R411gun/Powercore-V2.0/Powercore-V2.0 Motherboard/KiCAD/CHARGER_POWER_STAGE.kicad_sch

## KiCad design Powercore-V2.0 Motherboard/KiCAD/CHARGER_POWER_STAGE.kicad_sch (2024-09-20)

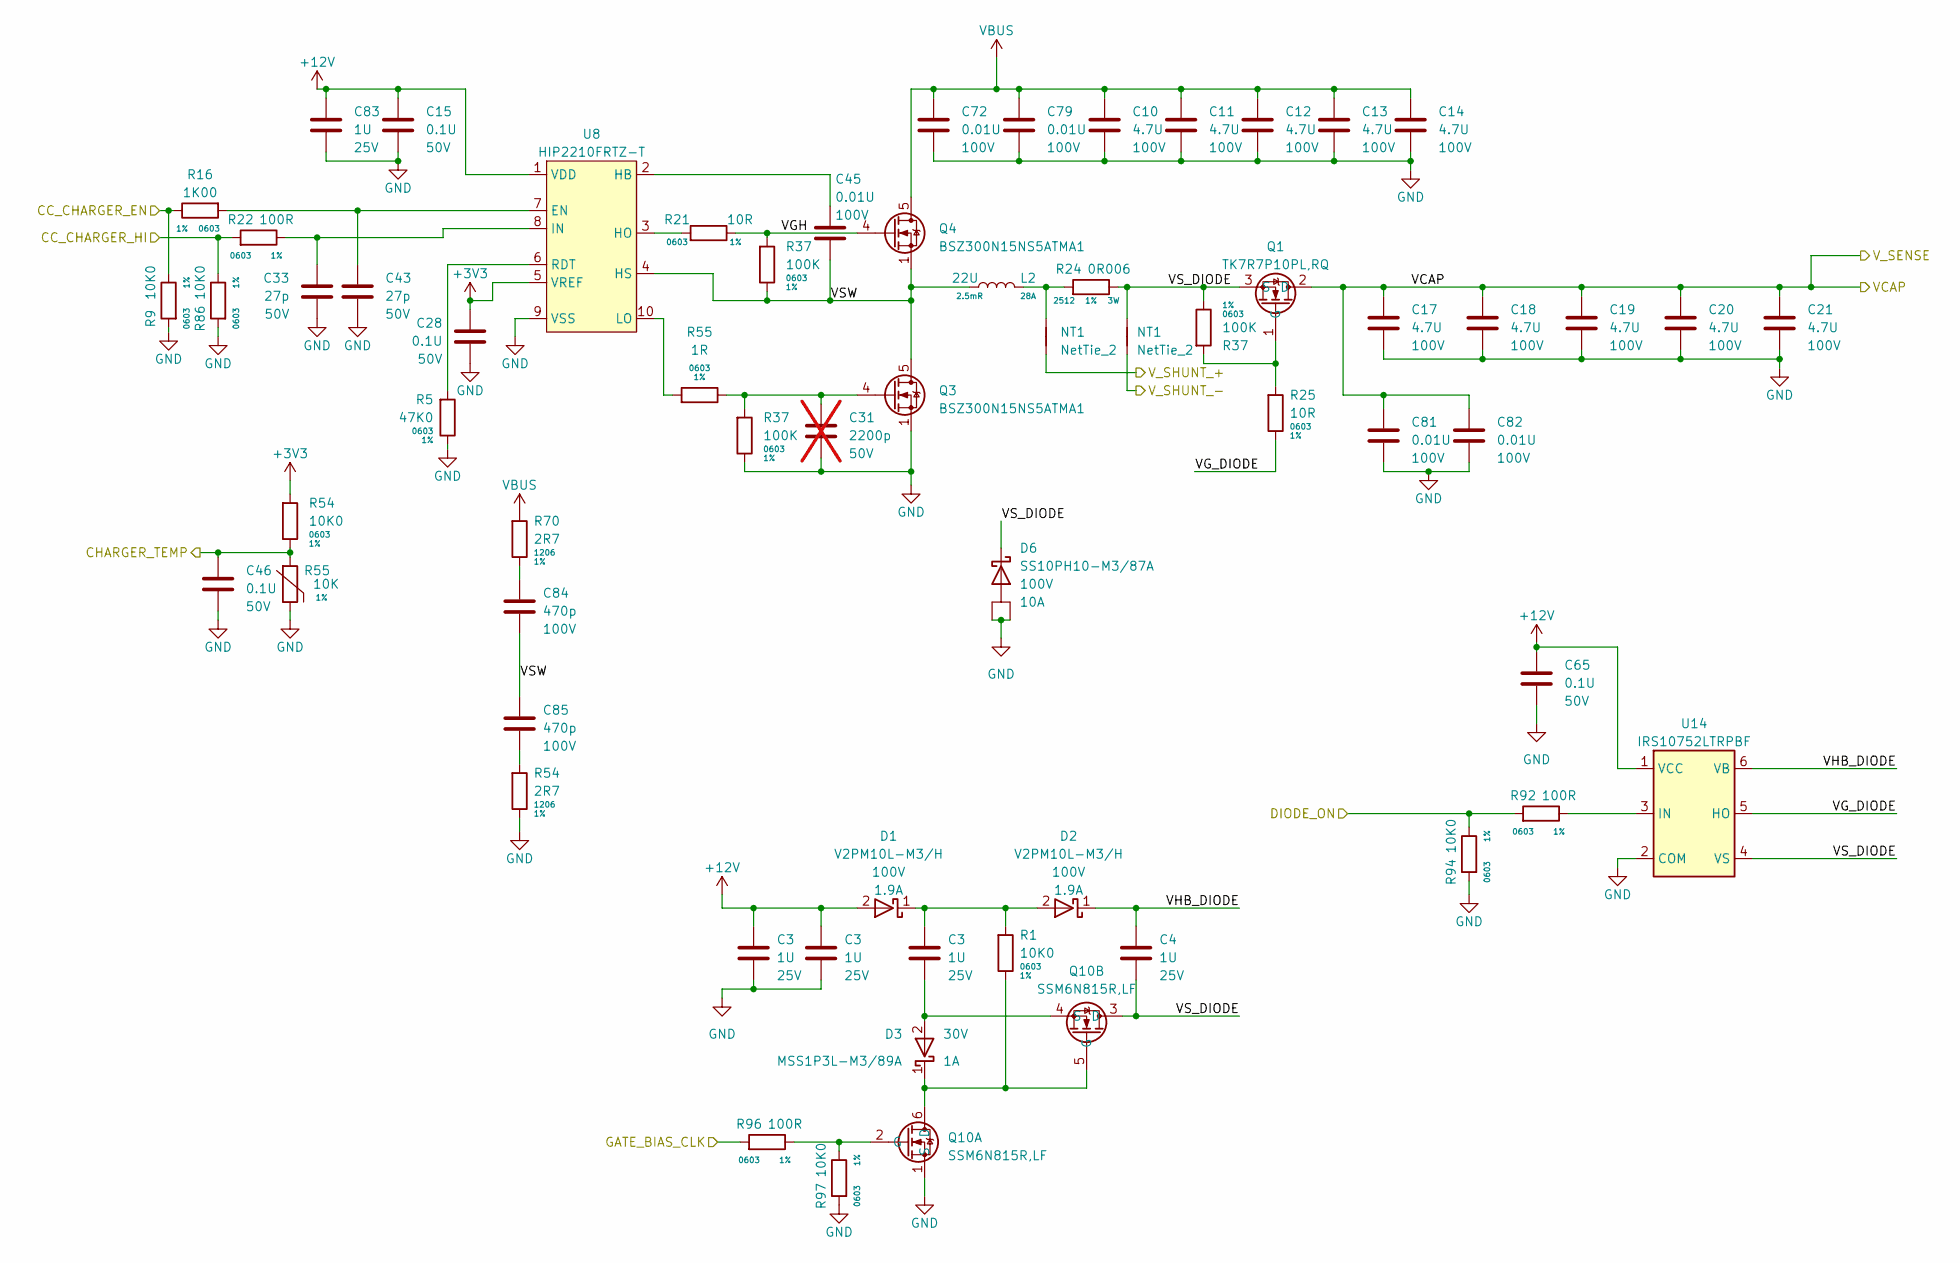
[picture p1: schematic CHARGER_POWER_STAGE.kicad_sch]

Parts:
C3, C4, C83: 1U; C_0603_1608Metric; Volage Rating 25V; Part Number CL10B105KA8NNNC
C10, C11, C12, C13, C14, C17, C18, C19, C20, C21: 4.7U; C_1206_3216Metric; Voltage Rating 100V; Part Number GRM31CC72A475KE11L
C15, C28, C46, C65: 0.1U; C_0603_1608Metric; Volage Rating 50V; Part Number CL10B104KB8NNWC
C31: 2200p; C_0603_1608Metric; Volage Rating 50V; Part Number CL10B222KB8NNNC; not fitted
C33, C43: 27p; C_0603_1608Metric; Volage Rating 50V; Part Number CC0603JRNPO9BN270
C45, C72, C79, C81, C82: 0.01U; C_0603_1608Metric; Volage Rating 100V; Part Number CL10B103KC8NNNC
C84, C85: 470p; C_0603_1608Metric; Volage Rating 100V; Part Number C0603C471J1GAC7867
D1, D2: V2PM10L-M3/H; DO-220AA (SMP); Voltage 100V; Part Number V2PM10L-M3/H
D3: MSS1P3L-M3/89A; D_MicroSMP_AK; Voltage 30V; Part Number MSS1P3L-M3/89A
D6: SS10PH10-M3/87A; TO-277A; Part Number SS10PH10-M3/87A
L2: 22U; PQ2617BHA; Part Number PQ2617BHA-220K
NT1: NetTie_2; NET_TIE_SMD_10mil
Q1: TK7R7P10PL,RQ; TO-252-2; Part Number TK7R7P10PL,RQ
Q3, Q4: BSZ300N15NS5ATMA1; INFINEON_TSDSON-8-25; Part Number BSZ300N15NS5ATMA1
Q10: SSM6N815R,LF; TSOP_6_2.5MM WIDTH; Part Number SSM6N815R,LF
R1, R9, R86, R94, R97: 10K0; R_0603_1608Metric; Tolerance 1%; Part Number RMCF0603FT10K0
R5: 47K0; R_0603_1608Metric; Tolerance 1%; Part Number RMCF0603FT47K0
R16: 1K00; R_0603_1608Metric; Tolerance 1%; Part Number RMCF0603FT1K00
R21, R25: 10R; R_0603_1608Metric; Tolerance 1%; Part Number RMCF0603FT10R0
R22, R92, R96: 100R; R_0603_1608Metric; Tolerance 1%; Part Number RMCF0603FT100R
R24: 0R006; CRE_2512_High_ohm; Tolerance 1%; Power Rating 3W; Part Number CRE2512-FZ-R006E-3
R37: 100K; R_0603_1608Metric; Tolerance 1%; Part Number RMCF0603FT100K
R54, R70: 2R7; R_1206_3216Metric; Tolerance 1%; Part Number CRCW12062R70JNEAHP
R55: 10K; R_0603_1608Metric; Tolerance 1%; Part Number NCU18XH103F60RB
U8: HIP2210FRTZ-T; TDFN-10_EP_2.6x3.0mm_P0.8mm; Part Number HIP2210FRTZ-T
U14: IRS10752LTRPBF; SOT-23-6; Part Number IRS10752LTRPBF

Connections:
+3V3: C28.1, R54.1, U8.5 (VREF)
+12V: C3.1, C15.1, C65.1, C83.1, D1.2 (A), U8.1 (VDD), U14.1 (VCC)
CC_CHARGER_EN: R9.2, R16.2
CC_CHARGER_HI: R22.1, R86.2
CHARGER_TEMP: C46.1, R54.2, R55.1
DIODE_ON: R92.1, R94.2
GATE_BIAS_CLK: R96.1
GND: C3.2, C10.2, C11.2, C12.2, C13.2, C14.2, C15.2, C17.2, C18.2, C19.2, C20.2, C21.2, C28.2, C31.2, C33.2, C43.2, C46.2, C65.2, C72.2, C79.2, C81.2, C82.2, C83.2, D6.1 (A), D6.2 (A), Q3.1 (S), Q10.1 (S), R5.2, R9.1, R37.2, R54.2, R55.2, R86.1, R94.1, R97.1, U8.9 (VSS), U8.EP (VSS), U14.2 (COM)
unnamed: C3.1, D1.1 (K), D2.2 (A), R1.1
unnamed: C3.2, D3.2 (A), Q10.4 (S)
unnamed: C31.1, Q3.4 (G), R37.1, R55.2
unnamed: C33.1, R22.2, U8.8 (IN)
unnamed: C43.1, R16.1, U8.7 (EN)
unnamed: C45.1, U8.2 (HB)
unnamed: C84.1, R70.2
unnamed: C85.2, R54.1
unnamed: D3.1 (K), Q10.5 (G), Q10.6 (D), R1.2
unnamed: L2.1, NT1.1, R24.1
unnamed: Q1.1 (G), R25.1, R37.1
unnamed: Q10.2 (G), R96.2, R97.2
unnamed: R5.1, U8.6 (RDT)
unnamed: R21.1, U8.3 (HO)
unnamed: R55.1, U8.10 (LO)
unnamed: R92.2, U14.3 (IN)
VBUS: C10.1, C11.1, C12.1, C13.1, C14.1, C72.1, C79.1, Q4.5 (D), R70.1
VGH: Q4.4 (G), R21.2, R37.1
VG_DIODE: R25.2, U14.5 (HO)
VHB_DIODE: C4.1, D2.1 (K), U14.6 (VB)
VSW: C45.2, C84.2, C85.1, L2.2, Q3.5 (D), Q4.1 (S), R37.2, U8.4 (HS)
VS_DIODE: C4.2, D6.3 (K), NT1.2, Q1.3 (S), Q10.3 (D), R24.2, R37.2, U14.4 (VS)
V_SENSE: C17.1, C18.1, C19.1, C20.1, C21.1, C81.1, C82.1, Q1.2 (D)
V_SHUNT_+: NT1.2
V_SHUNT_-: NT1.1
