R411gun/Powercore-V2.0/Powercore-V2.0 Motherboard/KiCAD/MICRO.kicad_sch

## KiCad design Powercore-V2.0 Motherboard/KiCAD/MICRO.kicad_sch (2024-09-20)

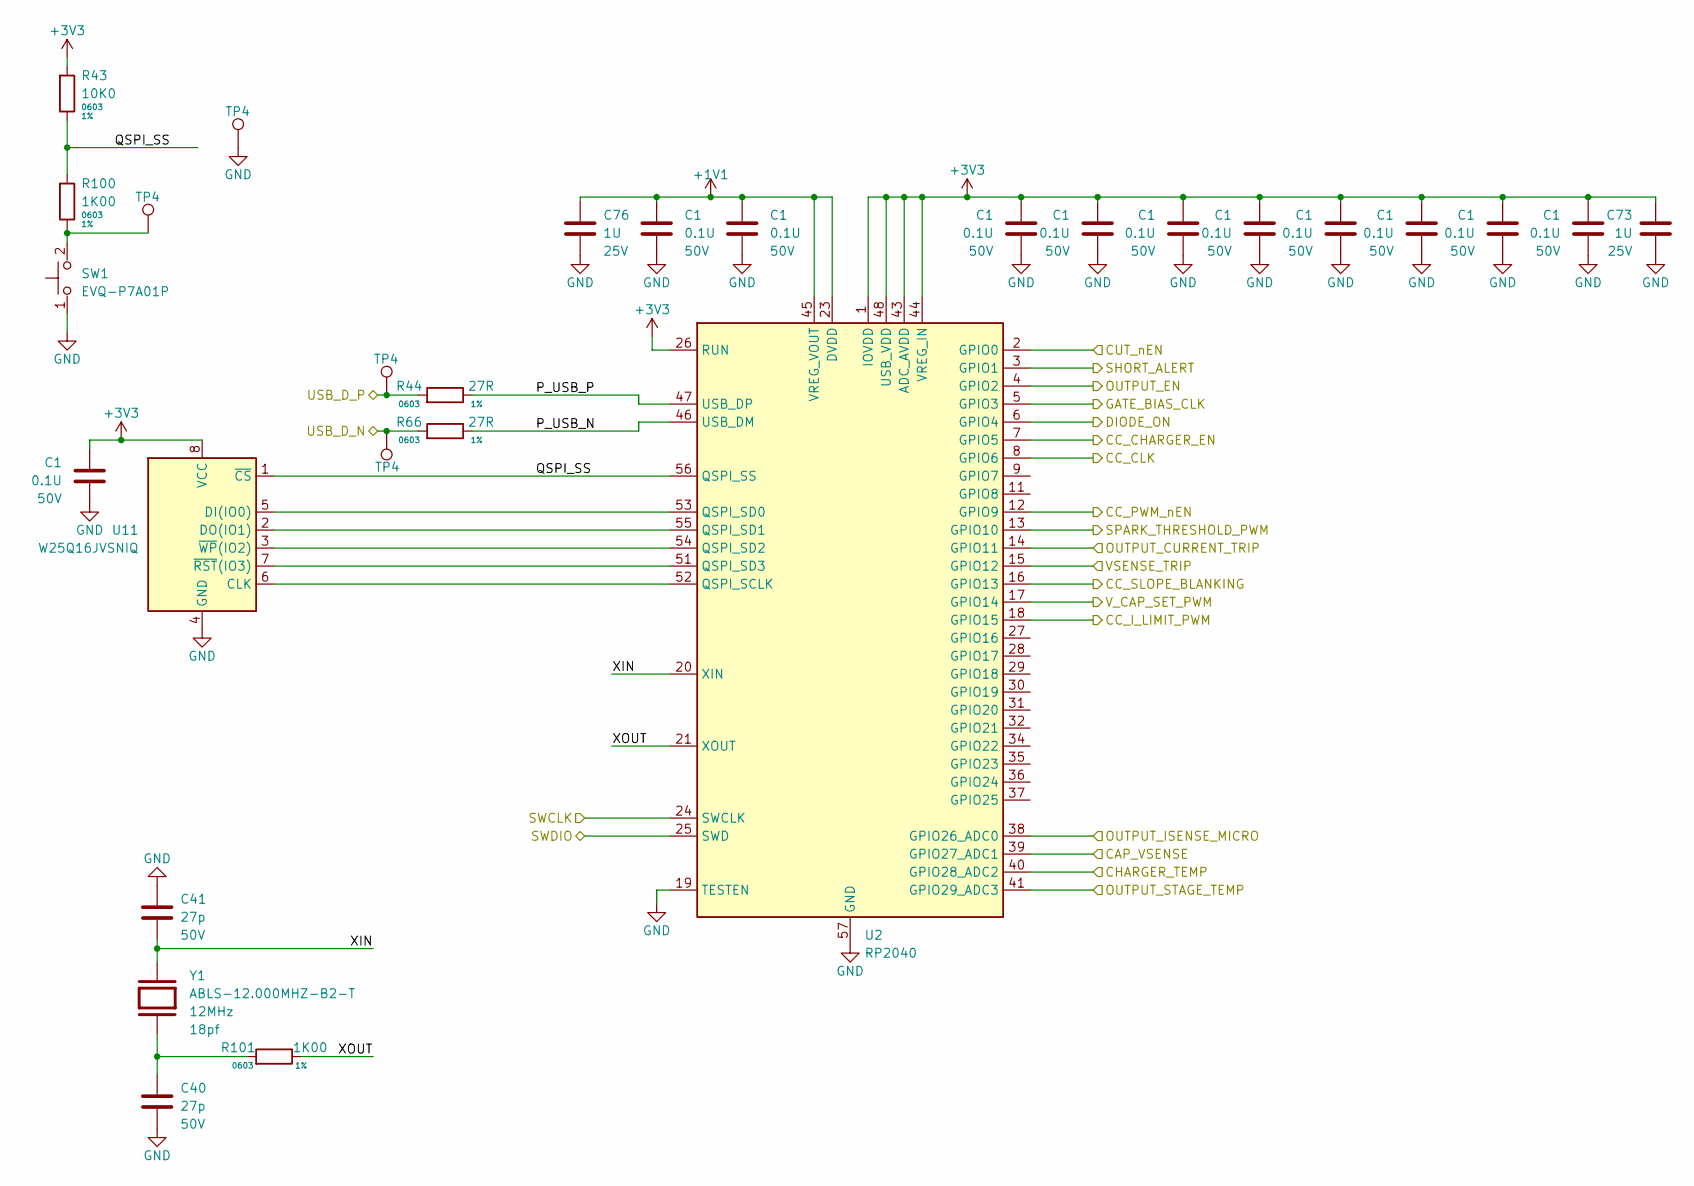
[picture p2: schematic MICRO.kicad_sch]

Parts:
C1: 0.1U; C_0603_1608Metric; Volage Rating 50V; Part Number CL10B104KB8NNWC
C40, C41: 27p; C_0603_1608Metric; Volage Rating 50V; Part Number CC0603JRNPO9BN270
C73, C76: 1U; C_0603_1608Metric; Volage Rating 25V; Part Number CL10B105KA8NNNC
R43: 10K0; R_0603_1608Metric; Tolerance 1%; Part Number RMCF0603FT10K0
R44, R66: 27R; R_0603_1608Metric; Tolerance 1%; Part Number RMCF0603FT27R0
R100, R101: 1K00; R_0603_1608Metric; Tolerance 1%; Part Number RMCF0603FT1K00
SW1: EVQ-P7A01P; SW_SPST_EVQP7A; Part Number EVQ-P7A01P
TP4: TestPoint; TestPoint_Pad_D1.5mm
U2: RP2040; QFN-56-1EP_7x7mm_P0.4mm_EP3.2x3.2mm; Part Number SC0914(7)
U11: W25Q16JVSNIQ; SOIC-8_3.9x4.9mm_P1.27mm; Part Number W25Q16JVSNIQ
Y1: ABLS-12.000MHZ-B2-T; Crystal_SMD_HC49-SD; Part Number ABLS-12.000MHZ-B2-T

Connections:
+1V1: C1.1, C76.1, U2.23 (DVDD), U2.45 (VREG_VOUT), U2.50 (DVDD)
+3V3: C1.1, C73.1, R43.1, U2.1 (IOVDD), U2.10 (IOVDD), U2.22 (IOVDD), U2.26 (RUN), U2.33 (IOVDD), U2.42 (IOVDD), U2.43 (ADC_AVDD), U2.44 (VREG_IN), U2.48 (USB_VDD), U2.49 (IOVDD), U11.8 (VCC)
CAP_VSENSE: U2.39 (GPIO27_ADC1)
CC_CHARGER_EN: U2.7 (GPIO5)
CC_CLK: U2.8 (GPIO6)
CC_I_LIMIT_PWM: U2.18 (GPIO15)
CC_PWM_nEN: U2.12 (GPIO9)
CC_SLOPE_BLANKING: U2.16 (GPIO13)
CHARGER_TEMP: U2.40 (GPIO28_ADC2)
CUT_nEN: U2.2 (GPIO0)
DIODE_ON: U2.6 (GPIO4)
GATE_BIAS_CLK: U2.5 (GPIO3)
GND: C1.2, C40.2, C41.1, C73.2, C76.2, SW1.1, TP4.1, U2.19 (TESTEN), U2.57 (GND), U11.4 (GND)
unnamed: C40.1, R101.1, Y1.1
unnamed: R100.2, SW1.2, TP4.1
unnamed: U2.55 (QSPI_SD1), U11.2 (DO(IO1))
unnamed: U2.54 (QSPI_SD2), U11.3 (~WP(IO2))
unnamed: U2.53 (QSPI_SD0), U11.5 (DI(IO0))
unnamed: U2.52 (QSPI_SCLK), U11.6 (CLK)
unnamed: U2.51 (QSPI_SD3), U11.7 (~RST(IO3))
OUTPUT_CURRENT_TRIP: U2.14 (GPIO11)
OUTPUT_EN: U2.4 (GPIO2)
OUTPUT_ISENSE_MICRO: U2.38 (GPIO26_ADC0)
OUTPUT_STAGE_TEMP: U2.41 (GPIO29_ADC3)
P_USB_N: R66.2, U2.46 (USB_DM)
P_USB_P: R44.2, U2.47 (USB_DP)
QSPI_SS: R43.2, R100.1, U2.56 (QSPI_SS), U11.1 (~CS)
SHORT_ALERT: U2.3 (GPIO1)
SPARK_THRESHOLD_PWM: U2.13 (GPIO10)
SWCLK: U2.24 (SWCLK)
SWDIO: U2.25 (SWD)
USB_D_N: R66.1, TP4.1
USB_D_P: R44.1, TP4.1
VSENSE_TRIP: U2.15 (GPIO12)
V_CAP_SET_PWM: U2.17 (GPIO14)
XIN: C41.2, U2.20 (XIN), Y1.2
XOUT: R101.2, U2.21 (XOUT)
