R411gun/Powercore-V2.0/Powercore-V2.0 Motherboard/KiCAD/MONITORING.kicad_sch

## KiCad design Powercore-V2.0 Motherboard/KiCAD/MONITORING.kicad_sch (2024-09-20)

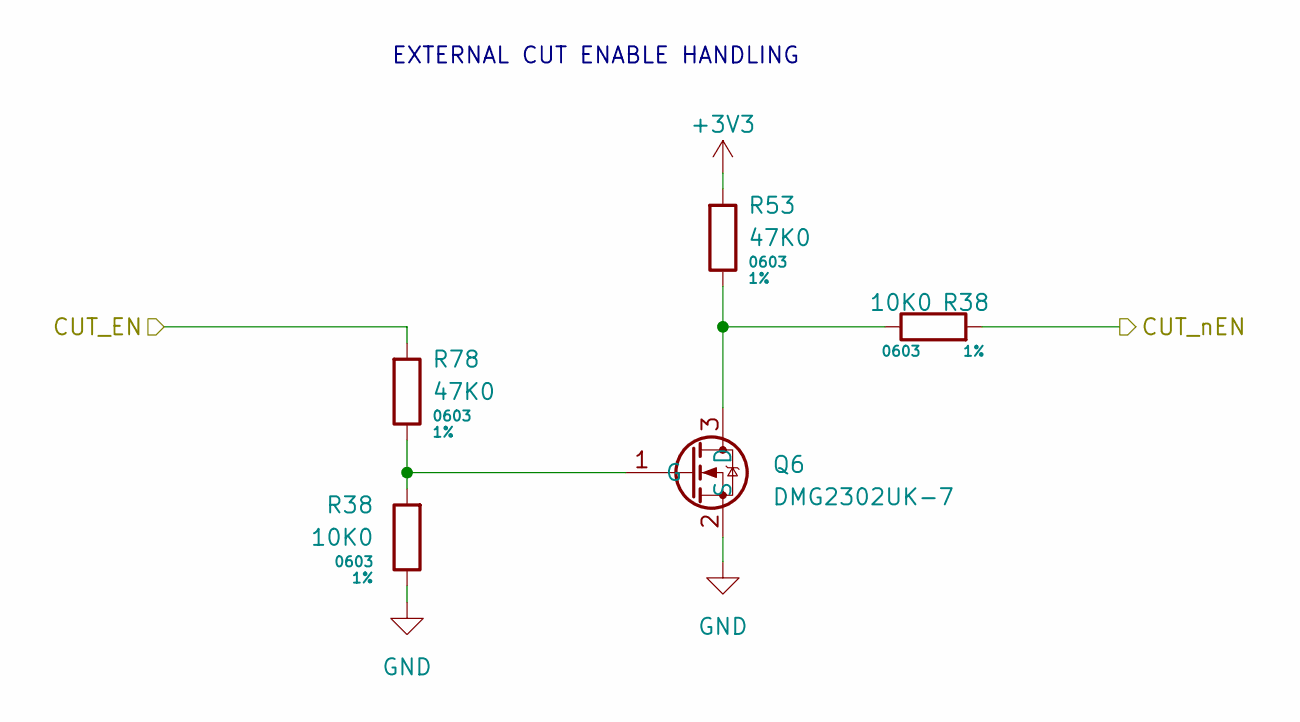
[picture p3: schematic MONITORING.kicad_sch]

Parts:
Q6: DMG2302UK-7; SOT-23-3; Part Number DMG2302UK-7
R38: 10K0; R_0603_1608Metric; Tolerance 1%; Part Number RMCF0603FT10K0
R53, R78: 47K0; R_0603_1608Metric; Tolerance 1%; Part Number RMCF0603FT47K0

Connections:
+3V3: R53.1
CUT_EN: R78.1
CUT_nEN: R38.1
GND: Q6.2 (S), R38.2
unnamed: Q6.1 (G), R38.1, R78.2
unnamed: Q6.3 (D), R38.2, R53.2

Notes on the sheet:
EXTERNAL CUT ENABLE HANDLING
