R411gun/Powercore-V2.0/Powercore-V2.0 Motherboard/KiCAD/POWER.kicad_sch

## KiCad design Powercore-V2.0 Motherboard/KiCAD/POWER.kicad_sch (2024-09-20)

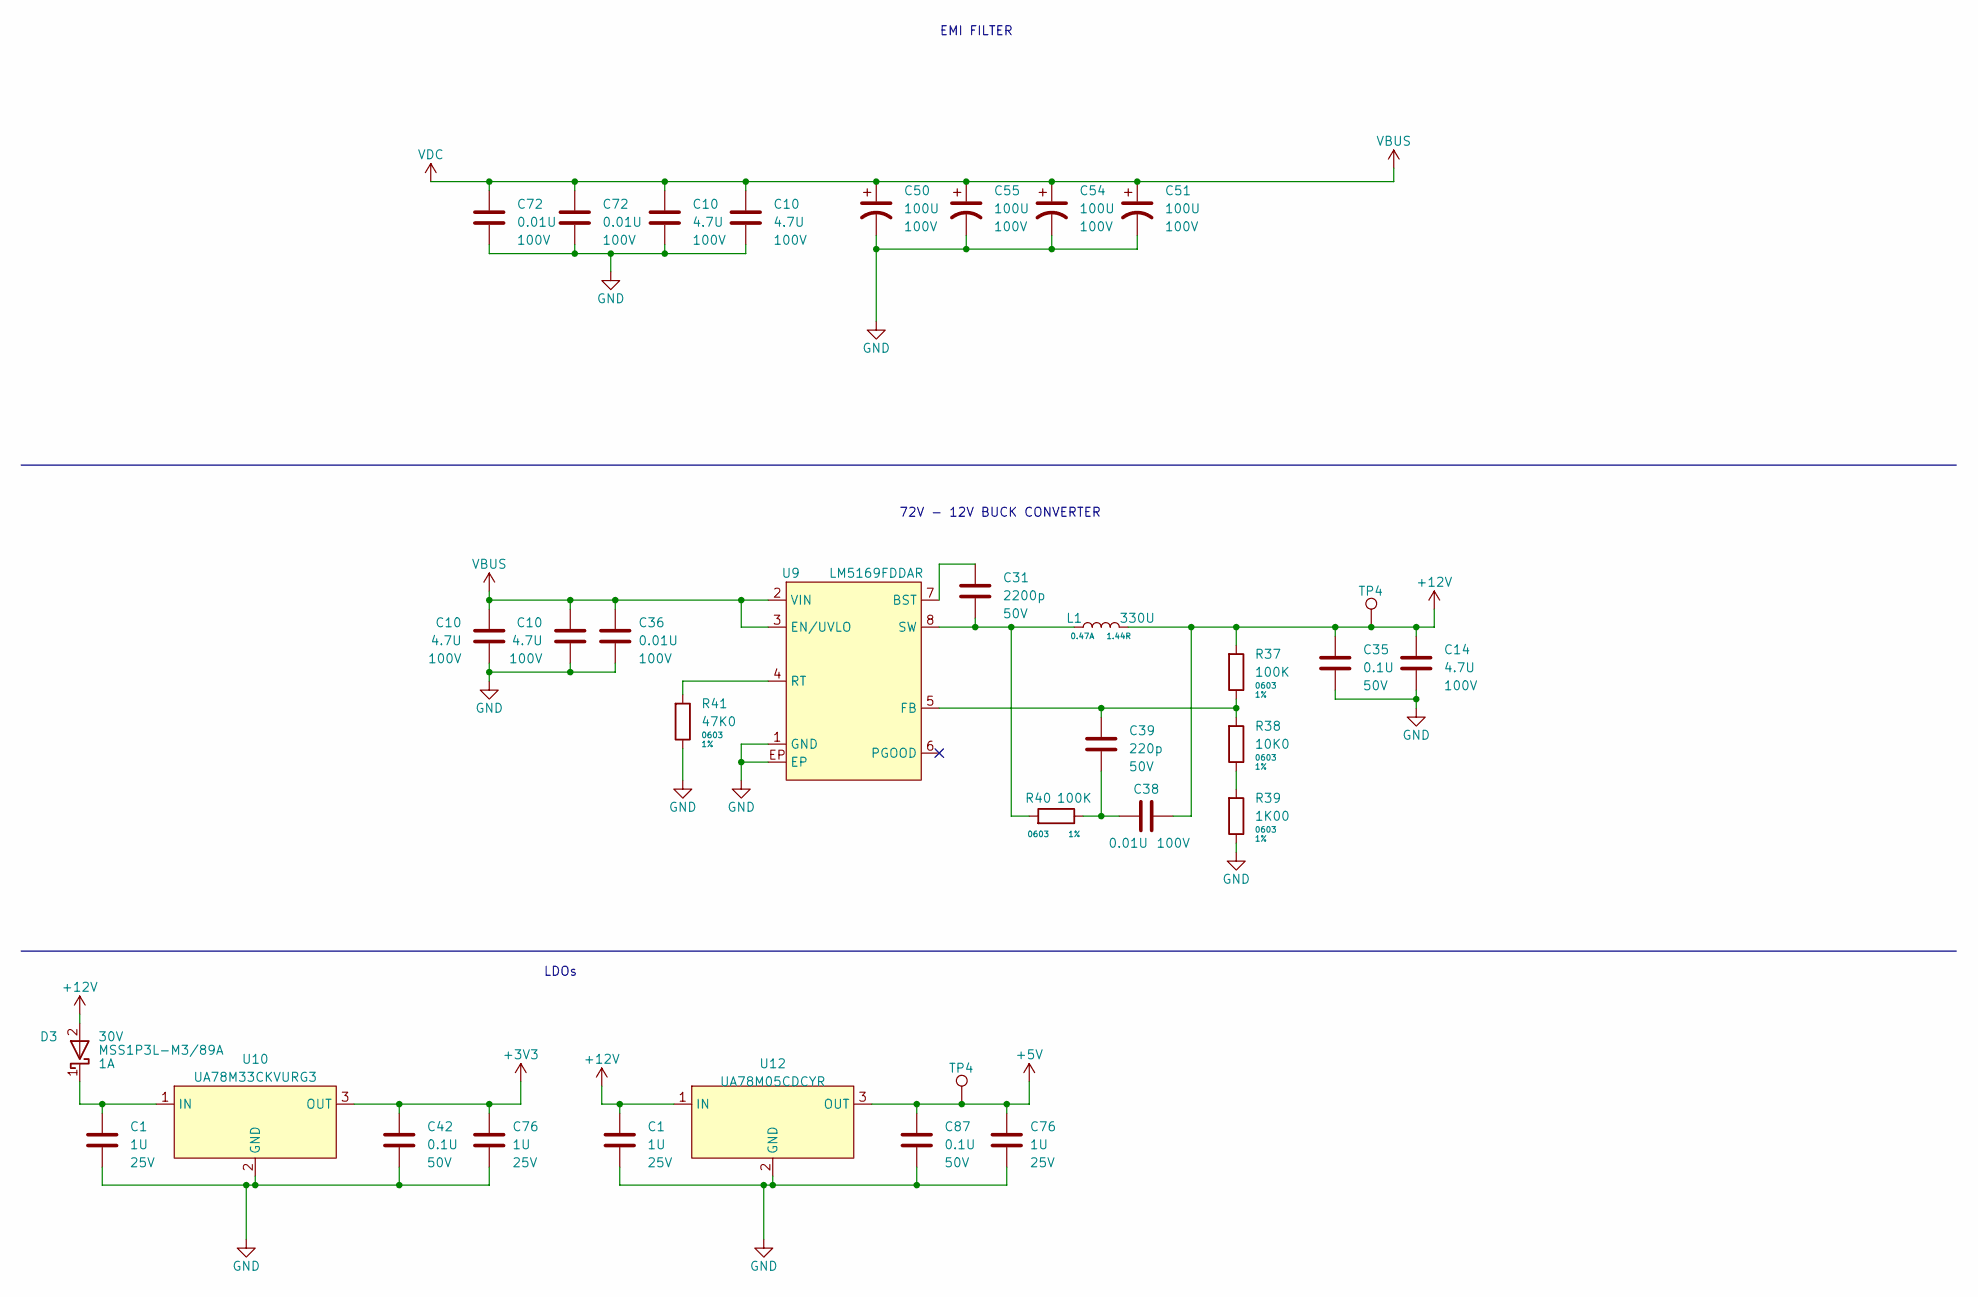
[picture p4: schematic POWER.kicad_sch]

Parts:
C1, C76: 1U; C_0603_1608Metric; Volage Rating 25V; Part Number CL10B105KA8NNNC
C10, C14: 4.7U; C_1206_3216Metric; Voltage Rating 100V; Part Number GRM31CC72A475KE11L
C31: 2200p; C_0603_1608Metric; Volage Rating 50V; Part Number CL10B222KB8NNNC
C35, C42, C87: 0.1U; C_0603_1608Metric; Volage Rating 50V; Part Number CL10B104KB8NNWC
C36, C38, C72: 0.01U; C_0603_1608Metric; Volage Rating 100V; Part Number CL10B103KC8NNNC
C39: 220p; C_0603_1608Metric; Volage Rating 50V; Part Number CL10B221JB8NNNC
C50, C51, C54, C55: 100U; CP_Radial_D10.0mm_P5.00mm; Voltage Rating 100V; Part Number 100ZLJ100M10X20
D3: MSS1P3L-M3/89A; D_MicroSMP_AK; Voltage 30V; Part Number MSS1P3L-M3/89A
L1: 330U; VLS6045EX; Part Number VLS6045EX-331M
R37, R40: 100K; R_0603_1608Metric; Tolerance 1%; Part Number RMCF0603FT100K
R38: 10K0; R_0603_1608Metric; Tolerance 1%; Part Number RMCF0603FT10K0
R39: 1K00; R_0603_1608Metric; Tolerance 1%; Part Number RMCF0603FT1K00
R41: 47K0; R_0603_1608Metric; Tolerance 1%; Part Number RMCF0603FT47K0
TP4: TestPoint; TestPoint_Pad_D1.5mm
U9: LM5169FDDAR; LM5169_POWERPAD_SOIC8; Part Number LM5169FDDAR
U10: UA78M33CKVURG3; TO-252-2; Part Number UA78M33CKVURG3
U12: UA78M05CDCYR; SOT-223-3_TabPin2; Part Number UA78M05CDCYR

Connections:
+3V3: C42.1, C76.1, U10.3 (OUT)
+5V: C76.1, C87.1, TP4.1, U12.3 (OUT)
+12V: C1.1, C14.1, C35.1, C38.2, D3.2 (A), L1.2, R37.1, TP4.1, U12.1 (IN)
GND: C1.2, C10.2, C14.2, C35.2, C36.2, C42.2, C50.2, C51.2, C54.2, C55.2, C72.2, C76.2, C87.2, R39.2, R41.2, U9.1 (GND), U9.EP, U10.2 (GND), U12.2 (GND)
unnamed: C1.1, D3.1 (K), U10.1 (IN)
unnamed: C31.1, U9.7 (BST)
unnamed: C31.2, L1.1, R40.1, U9.8 (SW)
unnamed: C38.1, C39.2, R40.2
unnamed: C39.1, R37.2, R38.1, U9.5 (FB)
unnamed: R38.2, R39.1
unnamed: R41.1, U9.4 (RT)
VBUS: C10.1, C36.1, C50.1, C51.1, C54.1, C55.1, C72.1, U9.2 (VIN), U9.3 (EN/UVLO)

Notes on the sheet:
EMI FILTER
LDOs
72V - 12V BUCK CONVERTER
